hanane-ai/Mobile-Robot-Design-/BOM with prices and supplier.xlsx

Bill of Materials (BOM)
Reference | Qty | Value | Price | supplier
C1 | 1 | 100uF | €10.00 | link (https://www.temu.com/at-en/500pcs-electrolytic-capacitor--sizes-0-1uf-1000uf-10v-50v-with-durable-plastic-organizer-g-601103016290387.html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)
C2 | 1 | 220uF
C3, C4 | 2 | 100nF
C5 | 1 | 10uF
D1-D4 | 4 | LED | €0.45 | link (https://www.reichelt.at/at/de/shop/produkt/led_5_mm_bedrahtet_kaltweiss_12000_mcd_15_-61103)
D5-D8, D10-D13 | 8 | 1N4007 | €2.68 | link (https://www.temu.com/at-en/10-specifications-of-100pcs-of-1n4001-1n4002-1n4003-1n4004-1n4006-1n4007-1n5817-1n5818-1n5819---diode-box-set-g-601100091673377.htm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)
D9 | 1 | 1N5822
J1 | 1 | PWR IN | €3.06 | link (https://www.temu.com/at-en/5pairs-connector-plug-12v---adapter-connector-male-to-female-for-tv-camera-single-color-led-strips-g-601102122899231.html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)
J2 | 1 | motor A | €0.60 | link (https://www.tandmore.de/Installation/Phoenix-Contact/Phoenix-Contact-1836189-MC-1-5-2-G-5-08-Grundleiste::586661.html)
J3 | 1 | motor B | €0.60 | link (https://www.tandmore.de/Installation/Phoenix-Contact/Phoenix-Contact-1836189-MC-1-5-2-G-5-08-Grundleiste::586661.html)
J4 | 1 | Conn_01x03_Pin | €0.59 | link (https://www.elecbee.com/en/product-detail/elecbee-pin-header-2-54mm-pitch-1x3-pin-horizontal-insert-square-pins_104902)
J5 | 1 | Conn_01x04_Pin | €13.24 | link (https://www.elecbee.com/en/product-detail/elecbee-header-pins-2-54mm-pitch-1x4-pin-vertical-connector_94590)
J6 | 1 | LED_OUT | €0.43 | link (https://www.jakelectronics.com/productdetail/molex-0022289080-6432744)
J7 | 1 | LED_IN | €0.43 | link (https://www.jakelectronics.com/productdetail/molex-0022289080-6432744)
L1 | 1 | 68uH | €5.96 | link (https://www.mouser.at/ProductDetail/Vishay-Dale/IHD1EB680L)
Q1 | 1 | 2N2219 | €6.00 | link (https://shop.mepatronik.de/en/2N4033-TO39-TRANSISTOR-PNP-THT-CDIL/1004933)
R1, R2 | 2 | 20 ohm | €13.33 | link (https://www.temu.com/at-en/assortment-of-metal-film-resistors-1450pcs-ranging-from-1-ohm-to-1m-ohm-with-1-tolerance-and-1-4w--ideal-for-and-experiments-g-6010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)
R3, R5 | 2 | 10k ohm
R4 | 1 | 20k ohm
R6 | 1 | 1k ohm
U1 | 1 | ESP32-C3-DevKitM-1 | €2.80 | link (https://www.temu.com/at-en/1pc-type-c-esp32-c3-development-board-esp32--development-board-esp32-development-board-g-605563341633079.html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)
U2 | 1 | L298N | €1.13 | link (https://de.aliexpress.com/item/1005006982852358.html?curPageLogUid=UNHrf7qSVaWf)
U3 | 1 | LM2596S-5 | €2.33 | link (https://www.conrad.at/de/p/texas-instruments-lm2596s-5-0-nopb-pmic-spannungsregler-linear-ldo-tube-2993695.html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)
Total | 36 |  | €63.63
