hanane-ai/Mobile-Robot-Design-/pcb.csv

Reference | Qty | Value | DNP | Exclude from BOM | Exclude from Board | Footprint | Datasheet
C1 | 1 | 100uF |  |  |  | Capacitor_THT:CP_Radial_D8.0mm_P3.50mm
C2 | 1 | 220uF |  |  |  | Capacitor_THT:C_Radial_D10.0mm_H12.5mm_P5.00mm
C3,C4 | 2 | 100nF |  |  |  | Capacitor_THT:C_Disc_D5.0mm_W2.5mm_P5.00mm
C5 | 1 | 10uF |  |  |  | Capacitor_THT:C_Radial_D5.0mm_H5.0mm_P2.00mm
D1,D2,D3,D4 | 4 | LED |  |  |  | LED_THT:LED_D5.0mm
D5,D6,D7,D8,D10,D11,D12,D13 | 8 | 1N4007 |  |  |  | Diode_THT:D_DO-41_SOD81_P10.16mm_Horizontal | http://www.vishay.com/docs/88503/1n4001.pdf
D9 | 1 | 1N5822 |  |  |  | Diode_THT:D_DO-201AD_P15.24mm_Horizontal | http://www.vishay.com/docs/88526/1n5820.pdf
J1 | 1 | PWR IN |  |  |  | Connector_BarrelJack:BarrelJack_Horizontal
J2 | 1 | motor A |  |  |  | Connector_Phoenix_MC:PhoenixContact_MC_1,5_2-G-3.5_1x02_P3.50mm_Horizontal
J3 | 1 | motor B |  |  |  | Connector_Phoenix_MC:PhoenixContact_MC_1,5_2-G-3.5_1x02_P3.50mm_Horizontal
J4 | 1 | Conn_01x03_Pin |  |  |  | Connector_PinHeader_2.54mm:PinHeader_1x03_P2.54mm_Vertical
J5 | 1 | Conn_01x04_Pin |  |  |  | Connector_PinHeader_2.54mm:PinHeader_1x04_P2.54mm_Vertical
J6 | 1 | LED_OUT |  |  |  | Connector_PinHeader_2.54mm:PinHeader_1x02_P2.54mm_Vertical_SMD_Pin1Left
J7 | 1 | LED_IN |  |  |  | Connector_PinHeader_2.54mm:PinHeader_1x02_P2.54mm_Vertical_SMD_Pin1Left
L1 | 1 | 68uH |  |  |  | Inductor_THT:L_Axial_L5.3mm_D2.2mm_P10.16mm_Horizontal_Vishay_IM-1
Q1 | 1 | 2N2219 |  |  |  | Package_TO_SOT_THT:TO-39-3 | http://www.onsemi.com/pub_link/Collateral/2N2219-D.PDF
R1,R2 | 2 | 20 |  |  |  | Resistor_THT:R_Axial_Power_L25.0mm_W9.0mm_P27.94mm
R3,R5 | 2 | 10k |  |  |  | Resistor_THT:R_Axial_DIN0207_L6.3mm_D2.5mm_P10.16mm_Horizontal
R4 | 1 | 20k |  |  |  | Resistor_THT:R_Axial_DIN0207_L6.3mm_D2.5mm_P10.16mm_Horizontal
R6 | 1 | 1k |  |  |  | Resistor_THT:R_Axial_DIN0207_L6.3mm_D2.5mm_P7.62mm_Horizontal
U1 | 1 | ESP32-C3-DevKitM-1 |  |  |  | RF_Module:ESP32-C3-DevKitM-1 | https://docs.espressif.com/projects/esp-idf/en/latest/esp32c3/hw-reference/esp32c3/user-guide-devkitm-1.html
U2 | 1 | L298N |  |  |  | Package_TO_SOT_THT:TO-220-15_P2.54x5.08mm_StaggerOdd_Lead4.58mm_Vertical | http://www.st.com/st-web-ui/static/active/en/resource/technical/document/datasheet/CD00000240.pdf
U3 | 1 | LM2596S-5 |  |  |  | Package_TO_SOT_SMD:TO-263-5_TabPin3 | http://www.ti.com/lit/ds/symlink/lm2596.pdf
