hanane-ai/Mobile-Robot-Design-/PCB.step

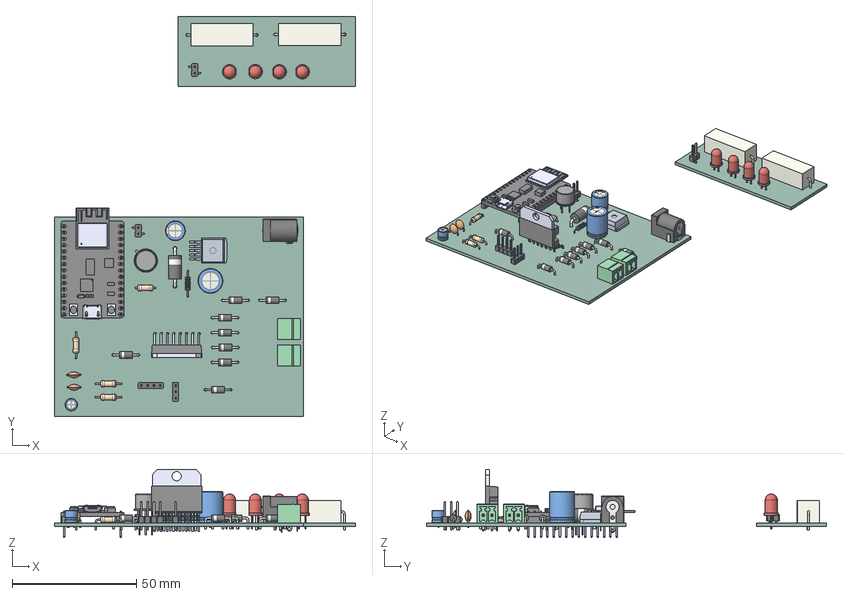
[picture p23: CAD file, 2026-06-24]
PCB.step
121.2 x 161.1 x 27.5 mm
R_Axial_DIN0207_L6.3mm_D2.5mm_P10.16mm_Horizontal x 3
C_Disc_D5.0mm_W2.5mm_P5.00mm x 2
LED_D5.0mm x 4
D_DO-41_SOD81_P10.16mm_Horizontal x 8
TO-39-3
PinHeader_1x04_P2.54mm_Vertical
D_DO-201AD_P15.24mm_Horizontal
C_Radial_D10.0mm_H12.5mm_P5.00mm
PhoenixContact_MC_1,5_2-G-3.5_1x02_P3.50mm_Horizontal x 2
L298N--3DModel-STEP-56544
L_Axial_L5.3mm_D2.2mm_P10.16mm_Horizontal_Vishay_IM-1
CP_Radial_D8.0mm_P3.50mm
BarrelJack_Horizontal
PCB 1.18.1
C_Radial_D5.0mm_H5.0mm_P2.00mm
PinHeader_1x02_P2.54mm_Vertical_SMD_Pin1Left x 2
R_Axial_DIN0207_L6.3mm_D2.5mm_P7.62mm_Horizontal
R_Axial_Power_L25.0mm_W9.0mm_P27.94mm x 2
PinHeader_1x03_P2.54mm_Vertical
ESP32-C3-DEVKITM-1_ESP32-C3-DEVKITM-1
CP2102N-A02-GQFN28_CP2102N-A02-GQFN28
1N5819HW-7-F_1N5819HW-7-F
ESP32-C3-MINI-1_ESP32-C3-MINI-1
USB3080-30-00-A-
pcb_PCB_1
pcb_PCB_2
