hanane-ai/Mobile-Robot-Design-/pcb.kicad_pcb

## KiCad design pcb.kicad_pcb (2026-06-24)

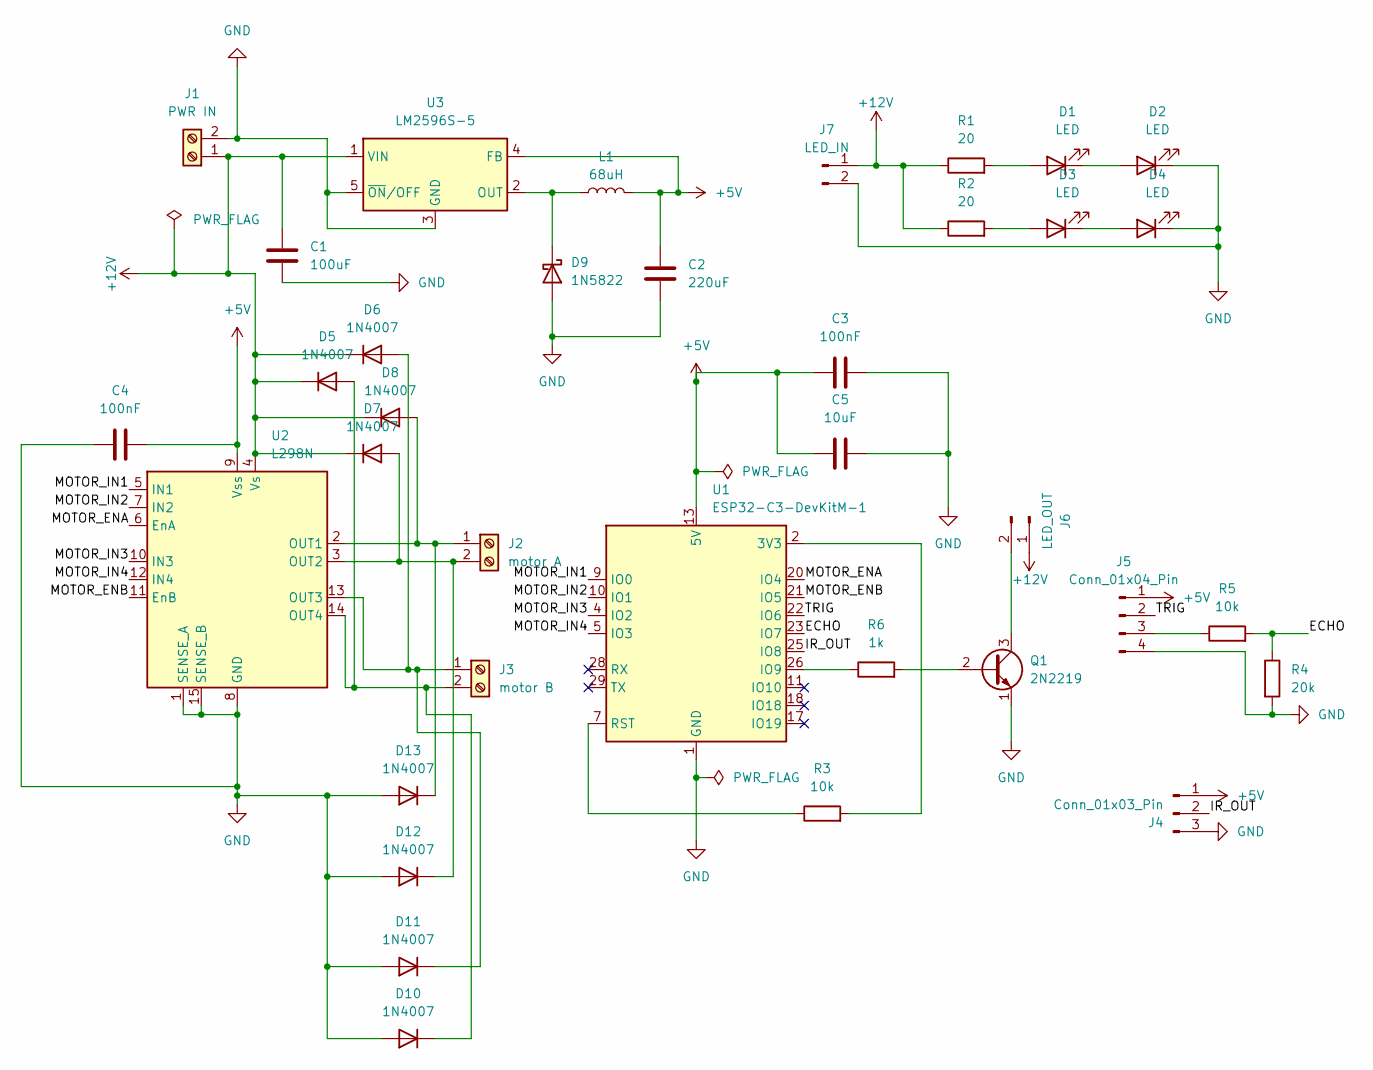
[picture p24: schematic pcb.kicad_sch]

Parts:
C1: 100uF; CP_Radial_D8.0mm_P3.50mm
C2: 220uF; C_Radial_D10.0mm_H12.5mm_P5.00mm
C3, C4: 100nF; C_Disc_D5.0mm_W2.5mm_P5.00mm
C5: 10uF; C_Radial_D5.0mm_H5.0mm_P2.00mm
D1, D2, D3, D4: LED; LED_D5.0mm
D5, D6, D7, D8, D10, D11, D12, D13: 1N4007; D_DO-41_SOD81_P10.16mm_Horizontal
D9: 1N5822; D_DO-201AD_P15.24mm_Horizontal
J1: PWR IN; BarrelJack_Horizontal
J2: motor A; PhoenixContact_MC_1,5_2-G-3.5_1x02_P3.50mm_Horizontal
J3: motor B; PhoenixContact_MC_1,5_2-G-3.5_1x02_P3.50mm_Horizontal
J4: Conn_01x03_Pin; PinHeader_1x03_P2.54mm_Vertical
J5: Conn_01x04_Pin; PinHeader_1x04_P2.54mm_Vertical
J6: LED_OUT; PinHeader_1x02_P2.54mm_Vertical_SMD_Pin1Left
J7: LED_IN; PinHeader_1x02_P2.54mm_Vertical_SMD_Pin1Left
L1: 68uH; L_Axial_L5.3mm_D2.2mm_P10.16mm_Horizontal_Vishay_IM-1
Q1: 2N2219; TO-39-3
R1, R2: 20; R_Axial_Power_L25.0mm_W9.0mm_P27.94mm
R3, R5: 10k; R_Axial_DIN0207_L6.3mm_D2.5mm_P10.16mm_Horizontal
R4: 20k; R_Axial_DIN0207_L6.3mm_D2.5mm_P10.16mm_Horizontal
R6: 1k; R_Axial_DIN0207_L6.3mm_D2.5mm_P7.62mm_Horizontal
U1: ESP32-C3-DevKitM-1
U2: L298N; TO-220-15_P2.54x5.08mm_StaggerOdd_Lead4.58mm_Vertical
U3: LM2596S-5; TO-263-5_TabPin3

Connections:
+5V: C2.1, C3.1, C4.2, C5.1, J4.1, J5.1, L1.2, U1.13 (5V), U1.14 (5V), U2.9 (Vss), U3.4 (FB)
+12V: C1.2, D5.1 (K), D6.1 (K), D7.1 (K), D8.1 (K), J1.1, J6.1, J7.1, R1.1, R2.1, U2.4 (Vs), U3.1 (VIN)
/ECHO: R4.1, R5.2, U1.23 (IO7)
/IR_OUT: J4.2, U1.25 (IO8)
/MOTOR_ENA: U1.20 (IO4), U2.6 (EnA)
/MOTOR_ENB: U1.21 (IO5), U2.11 (EnB)
/MOTOR_IN1: U1.9 (IO0), U2.5 (IN1)
/MOTOR_IN2: U1.10 (IO1), U2.7 (IN2)
/MOTOR_IN3: U1.4 (IO2), U2.10 (IN3)
/MOTOR_IN4: U1.5 (IO3), U2.12 (IN4)
/TRIG: J5.2, U1.22 (IO6)
GND: C1.1, C2.2, C3.2, C4.1, C5.2, D2.1 (K), D4.1 (K), D9.2 (A), D10.2 (A), D11.2 (A), D12.2 (A), D13.2 (A), J1.2, J4.3, J5.4, J7.2, Q1.1 (E), R4.2, U1.1 (GND), U1.6 (GND), U1.8 (GND), U1.12 (GND), U1.15 (GND), U1.16 (GND), U1.19 (GND), U1.24 (GND), U1.27 (GND), U1.30 (GND), U2.1 (SENSE_A), U2.8 (GND), U2.15 (SENSE_B), U3.3 (GND), U3.5 (~ON/OFF)
unnamed: D1.2 (A), R1.2
unnamed: D1.1 (K), D2.2 (A)
unnamed: D3.2 (A), R2.2
unnamed: D3.1 (K), D4.2 (A)
unnamed: D9.1 (K), L1.1, U3.2 (OUT)
unnamed: D5.2 (A), D10.1 (K), J3.2, U2.14 (OUT4)
unnamed: D6.2 (A), D11.1 (K), J3.1, U2.13 (OUT3)
unnamed: D7.2 (A), D12.1 (K), J2.2, U2.3 (OUT2)
unnamed: D8.2 (A), D13.1 (K), J2.1, U2.2 (OUT1)
unnamed: J5.3, R5.1
unnamed: J6.2, Q1.3 (C)
unnamed: Q1.2 (B), R6.2
unnamed: R3.2, U1.2 (3V3), U1.3 (3V3)
unnamed: R6.1, U1.26 (IO9)
unnamed: R3.1, U1.7 (RST)

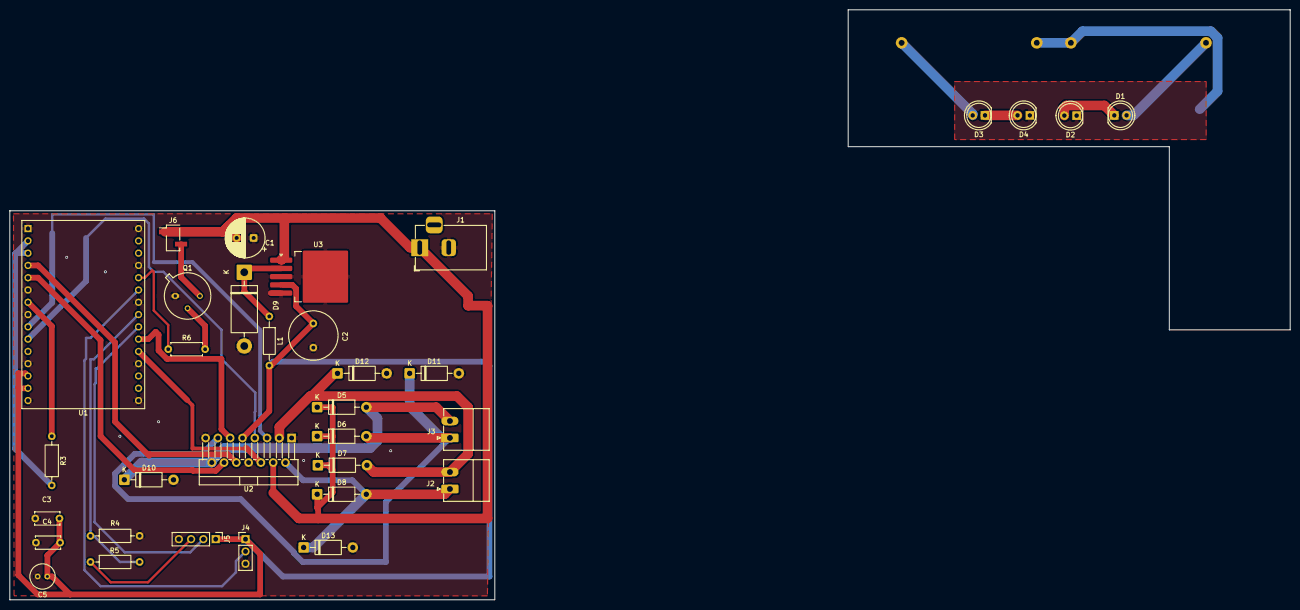
[picture p25: board pcb.kicad_pcb from above]

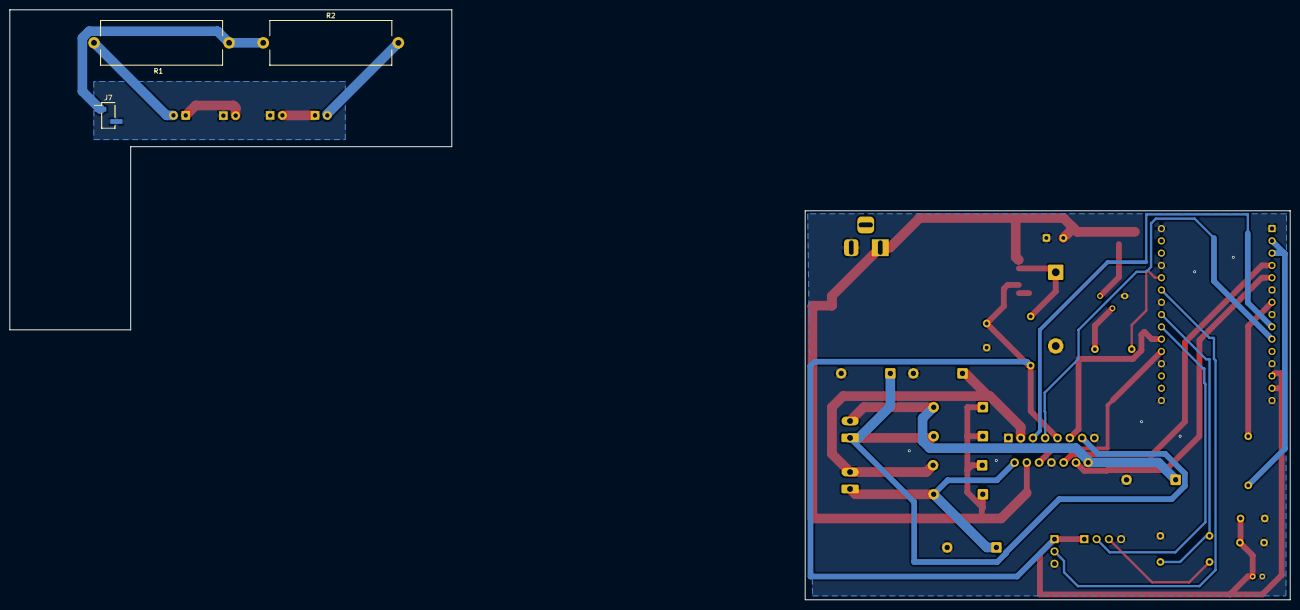
[picture p26: board pcb.kicad_pcb from below]

Board: 2 copper layers, 100.3 x 80.4 mm, 36 parts (3 on the bottom side), 27 nets.
